YEDITEPE-Sayisal-Tasarim-Toplulugu/7Yonga/README.md

# 7Yonga Projesi

Başvuru Yaptığı Takım Adı:
Yeditepe Üniversitesi Sayısal Tasarım Topluluğu 

Takım ID:
#582202 

Başvuru ID:
#3062081 

Takımımız, Yeditepe Üniversitesi Elektrik-Elektronik ve Bilgisayar Mühendisliği lisans
öğrencilerinden oluşmaktadır. 7Yonga projesi kapsamında, açık kaynaklı bir RISC-V çekirdeği, çevre
birimleri ve veri yolları ile özgün bir mikrodenetleyici tasarlamayı hedeflemekteyiz. Bu
mikrodenetleyici, yüksek doğruluk ve düşük güç tüketimi öncelikleri doğrultusunda geliştirilecektir.

## Üyeler
* Muhammet Furkan UZUN (İletişim Sorumlusu) (@mhfuzun)
  - Öğrenim: Yeditepe Üniversitesi, Elektrik-Elektronik Mühendisliği 2. Sınıf öğrencisi.
  - İş yükü: Çekirdeğin, belleklerin, veri yollarının implementasyonu,
donanım hızlandırıcı
* Hasan GÜZELŞEMME (@princeofyozgat)
  - Öğrenim: Yeditepe Üniversitesi, Bilgisayar Mühendisliği 3. Sınıf öğrencisi.
  - İş yükü: Çekirdek implementasyonu, çevre birimleri tasarımı, devre
serimi
* Erhan ÖNALDI (@ErhanOnaldi)
  - Öğrenim: Yeditepe Üniversitesi, Bilgisayar Mühendisliği 4. Sınıf öğrencisi.
  - İş yükü: Çevre Birimleri tasarımı, testler, donanım hızlandırıcı

## Tasarım
<div style="background-color: white; display: inline-block; padding: 0px; border-radius: 8px; box-shadow: 0 0 0px rgba(0,0,0,0.1);">
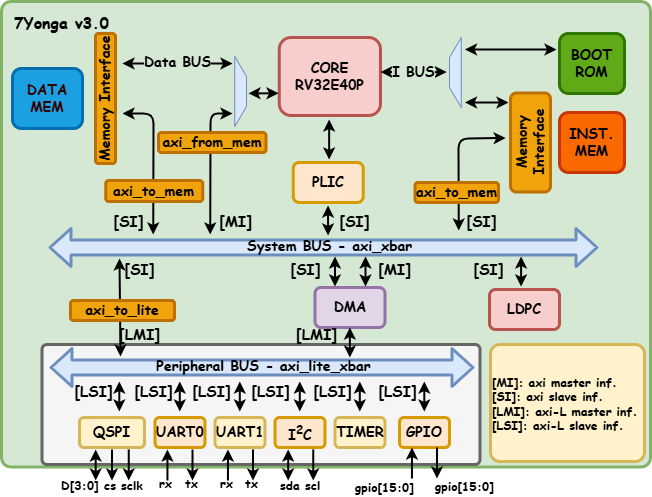
[picture p1: tasarımlar/görseller/YONGA-TASARIM-TOP_v3.0.drawio.png]
  
</div>

## Memory Map
<div style="background-color: white; display: inline-block; padding: 0px; border-radius: 8px; box-shadow: 0 0 0px rgba(0,0,0,0.1);">
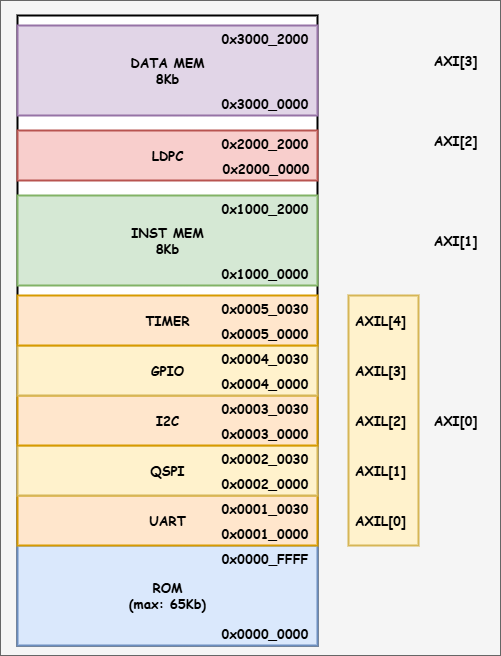
[picture p2: tasarımlar/görseller/YONGA-TASARIM-ADDR_MEMORY_MAP.drawio.png]
  
</div>

## İş Planı
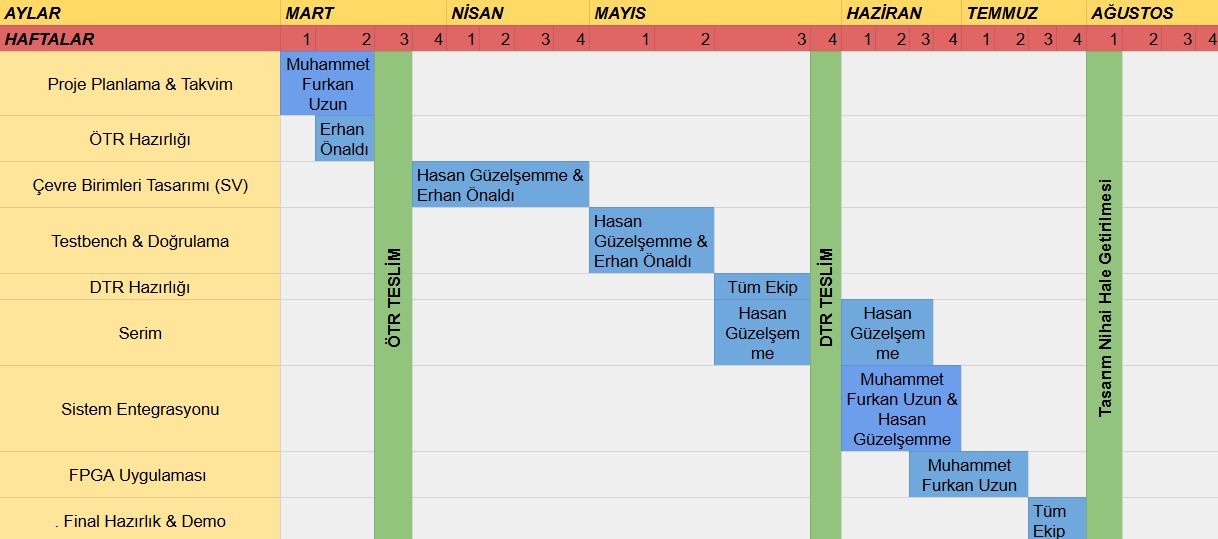
[picture p3: tasarımlar/görseller/isPlani.jpg]
İş Planı


## Dizin Yapısı:
```bash
7Yonga/
│
├── README.md               # Projenin tanıtım dosyası
├── LICENSE                 # Lisans bilgisi
├── .gitignore              # Git tarafından yok sayılacak dosyalar
├── requirements.txt        # Gerekli Python paketleri (Python için)
├── dependences.md          # Bağımlı olunan harici repolar (Makefile dependences ile toplu olarak "clone"'lanabilir)
│
├── docs/                   # Belgeler
│   └── kaynaklar/          # Referans Dokümanlar
|
├── tasarımlar/             # Proje tasarım klasörü, drawio tasarımlarını içerir
│   └── görseller/          # drawio tasarımlarının .jpg/.png çıktılarını içerir
│
├── teknofest/              # Teknofest 2025 Klasörü, Yarışma aşamlarını ve repor (şablonlarını) içerir.
│   └── önbaşvuru/          # Teknofest 2025 ~ Ön Başvuru Aşaması
│   └── dtr/                # Teknofest 2025 ~ DTR Aşaması
│   └── ötr/                # Teknofest 2025 ~ OTR Aşaması
|
│
├── firmware/               # Mikrodenetleyici yazılımlarını içerir
│   └── examples/           # Örnek kaynak kodlar
│   └── step0/              # Verification için kullanılan en basit test template'i
|
├── tasks/                  # Teknofest 2025 gerçekleştirilmesi gereken görevleri içerir
│   └── boot_steps/         # Boot süreci için gerekli donanım blokları ve betikleri bulunur.
│   └── core_verification/  # Çekirdek Doğrulaması Test Ortamı
│     └── testprogram/      # Test için kullanılan programları içerir
│     └── testsuit/         # Top modülü, Çekirdek için sarıcı modülü ve log üretici modülü içerir
│   └── LDPC/               # LDPC çalışma klasörü
│     └── articles/         # LDPC ile ilgli referans kaynaklar
│     └── pdfs/             # LPDC çalışma çıktıları
│   └── Verif/              # Verification ilgili dosyaları
|
├── gateware/               # HDL kodları
│   └── axi4/               # AXI4 Klasörü
│     └── axi/              # Harici AXI4 reposu
│     └── Makefile          # AXI4 reposunu klonlamak için betik
│     └── README.md         # AXI4 reposu ile ilgili karşılaşılan hatalar
│   └── core/               # CORE Klasörü (CV32E40P çekirdeğinin clone reposu)
│   └── inc/                # SOC için Systemverilog Header dosyaları
│   └── peripherals/        # Mikrodenetleyici Çevre Birimleri klasörü
│     └── uart/             # UART Çevre Birimi HDL ve test kodları
│     └── README.MD         #
│   └── pulp_common_cell/   # Pulp Common Cell klasörü, harici repo içerir
│     └── Makefile          # Pulp Common Cell reposunu klonlamak için betik
│   └── soc/                # Mikrodenetleyici SOC yapısına ait HDL kodlarını içerir
│     └── adapter/          # SOC içerisinde bulunan arayüzler için arayüz dönüşümlerini sağlar
│     └── core_interfaces/  # Çekirdeğin SOC içerisindeki sarıcı data&instruction arayüzlerini içerir
│   └── test/               # HDL test klasörü
│
```
