YEDITEPE-Sayisal-Tasarim-Toplulugu/7Yonga/tasarımlar/YONGA-TASARIM.drawio.pdf

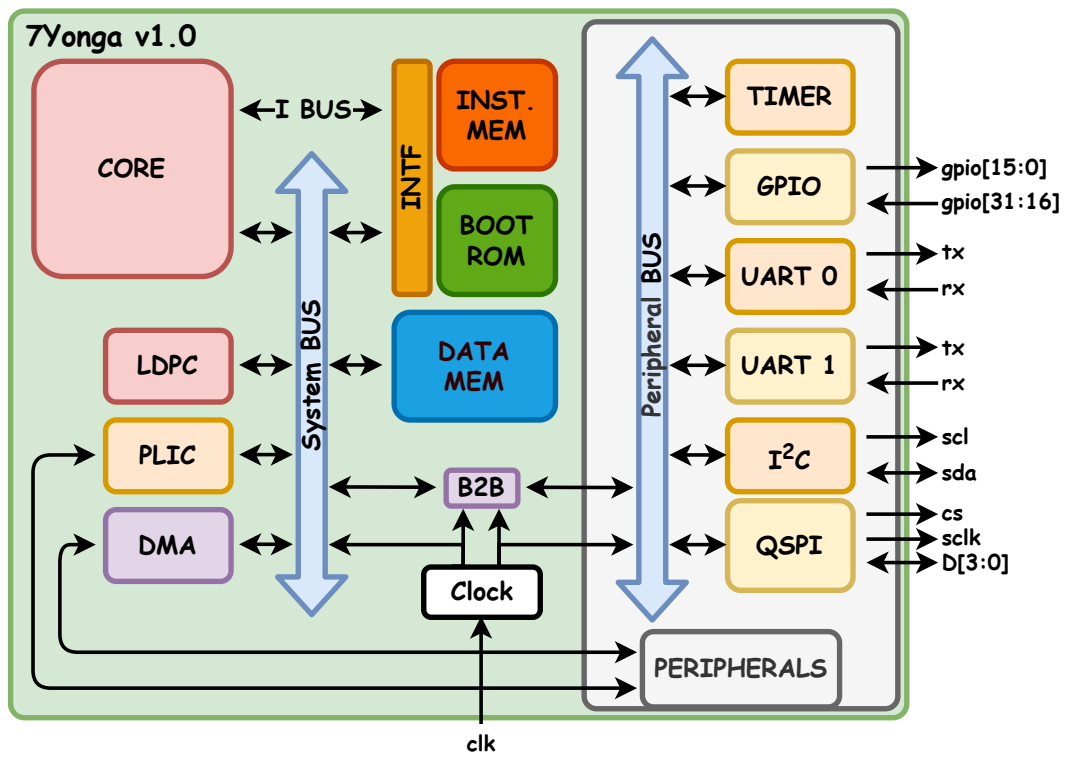
[picture p4: page 1]
CORE; System BUS; DATA MEM; INTF; I BUS; INST.; MEM; BOOT ROM; Peripheral BUS; UART 0; UART 1 I²C; QSPI; GPIO; TIMER; PERIPHERALS; LDPC; PLIC; DMA; Clock; 7Yonga v1.0; gpio[15:0] gpio[31:16]; scl sda cs sclk D[3:0]; clk

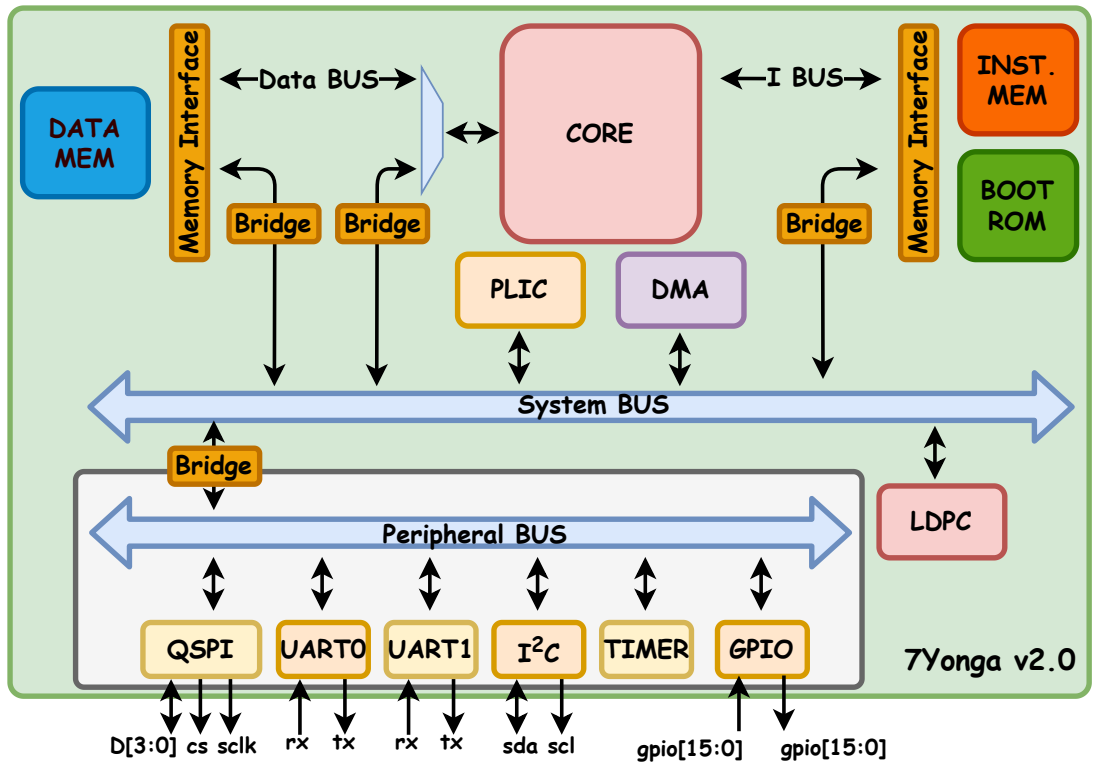
[picture p5: page 2]
CORE; System BUS; DATA MEM; Memory Interface; INST. MEM; BOOT ROM; Peripheral BUS; UART0 UART1; QSPI; TIMER GPIO; LDPC; PLIC; DMA; 7Yonga v2.0; Data BUS; I BUS; Bridge Bridge; Bridge; D[3:0] cs sclk; sda scl; gpio[15:0]

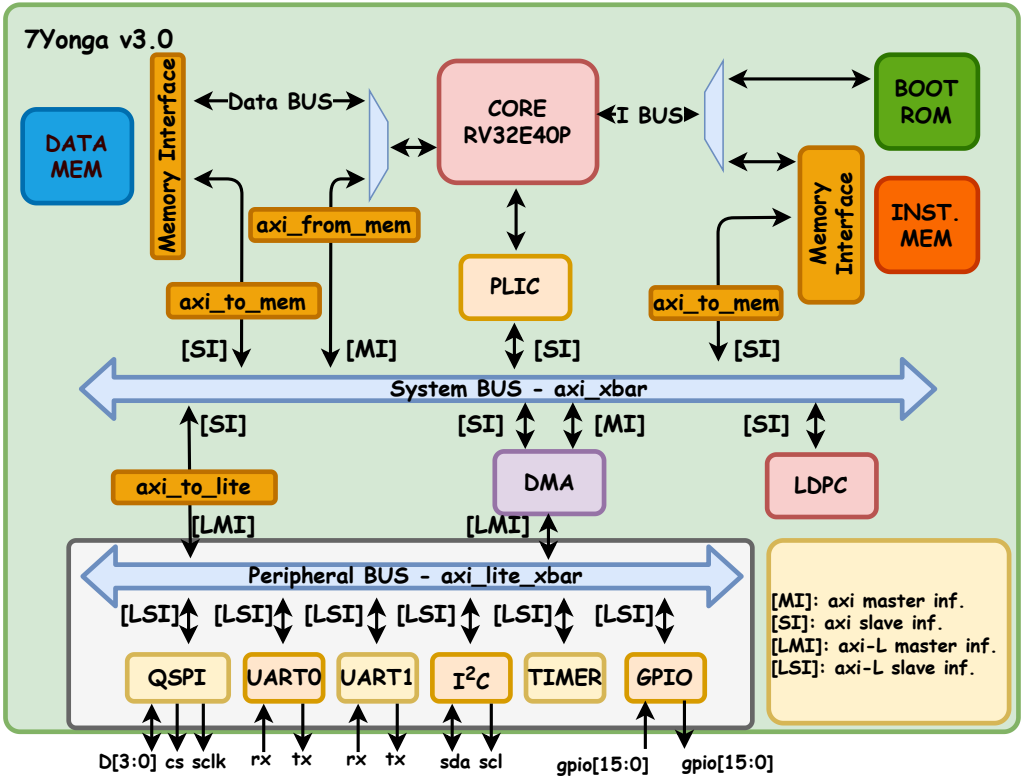
[picture p6: page 3]
CORE RV32E40P; System BUS - axi_xbar; DATA MEM; Memory; Interface; INST. MEM; BOOT ROM; Peripheral BUS - axi_lite_xbar; UART0 UART1; QSPI; TIMER GPIO; LDPC; PLIC; DMA; 7Yonga v3.0; I BUS; Data BUS; Memory Interface; axi_to_mem; axi_from_mem; axi_to_lite; D[3:0] cs sclk; sda scl; gpio[15:0]; [LMI]; [LSI]

[MI]: axi master inf.
[SI]: axi slave inf.
[LMI]: axi-L master inf.
[LSI]: axi-L slave inf.
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
