YEDITEPE-Sayisal-Tasarim-Toplulugu/7Yonga/teknofest/önbaşvuru/_#582202.pdf

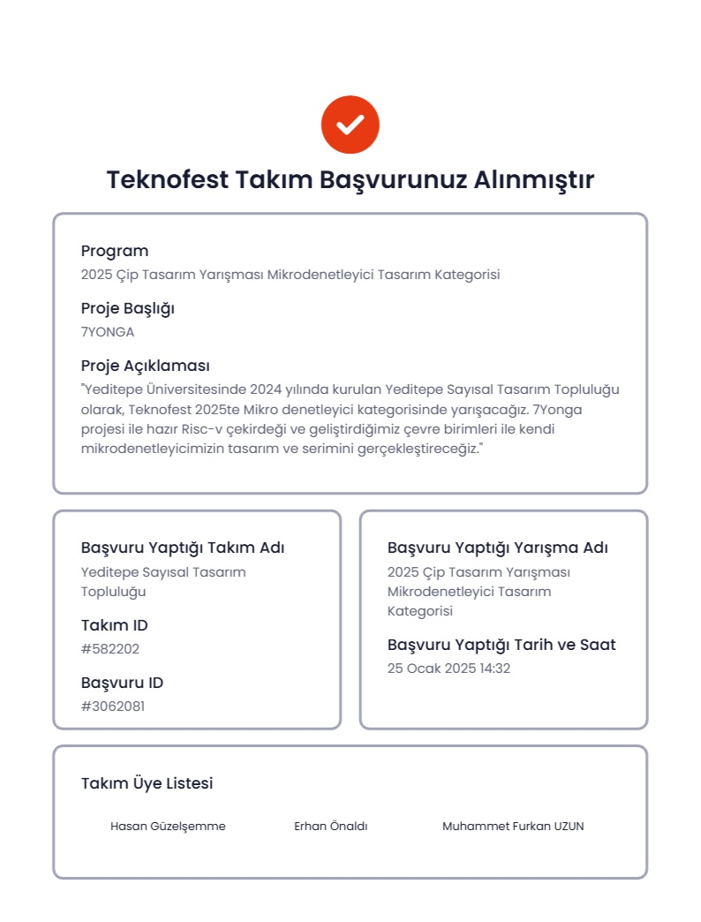
[picture p19: figure]
