YEDITEPE-Sayisal-Tasarim-Toplulugu/7Yonga/docs/kaynaklar/dma-interrupts.png

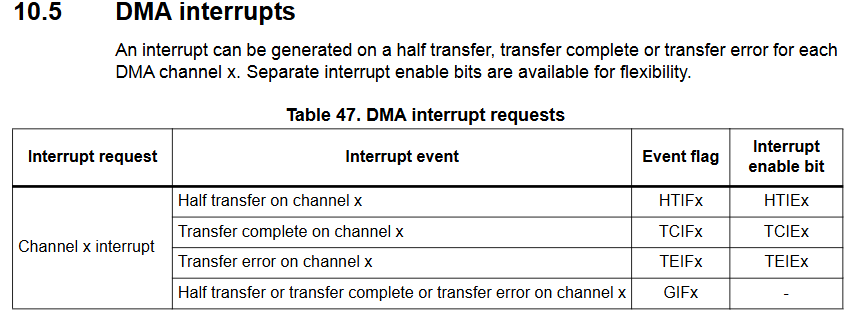
docs/kaynaklar/dma-interrupts.png
