YEDITEPE-Sayisal-Tasarim-Toplulugu/7Yonga/docs/kaynaklar/dma-tasarımı.png

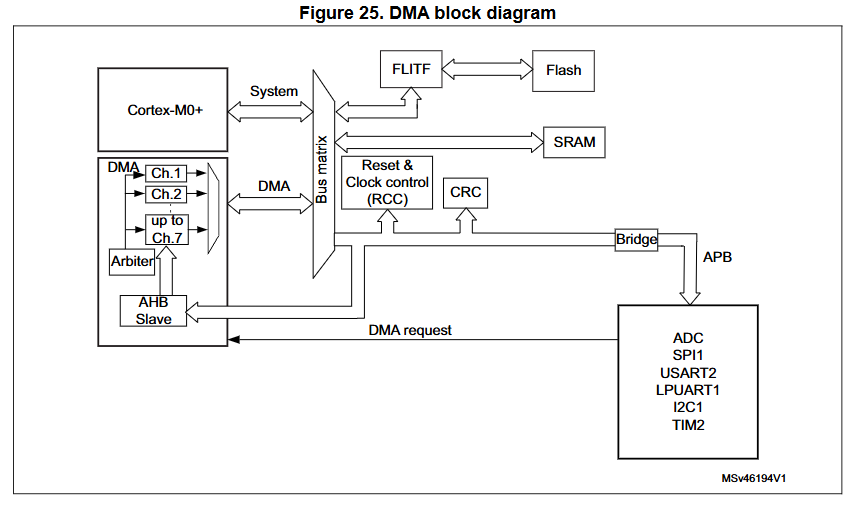
docs/kaynaklar/dma-tasarımı.png
