YEDITEPE-Sayisal-Tasarim-Toplulugu/7Yonga/tasarımlar/görseller/YONGA-TASARIM-BOOT-DEMO.drawio.png

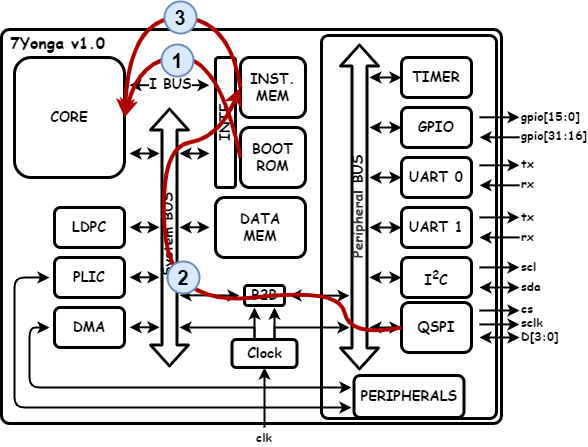
tasarımlar/görseller/YONGA-TASARIM-BOOT-DEMO.drawio.png
