YEDITEPE-Sayisal-Tasarim-Toplulugu/7Yonga/tasarımlar/görseller/YONGA-TASARIM-BOOT-DEMO_v2.0.drawio.png

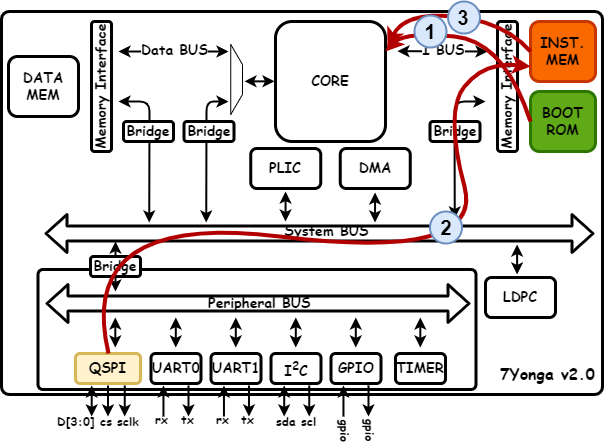
tasarımlar/görseller/YONGA-TASARIM-BOOT-DEMO_v2.0.drawio.png
