YEDITEPE-Sayisal-Tasarim-Toplulugu/7Yonga/tasarımlar/görseller/YONGA-TASARIM-data_interface_rapor.drawio.png

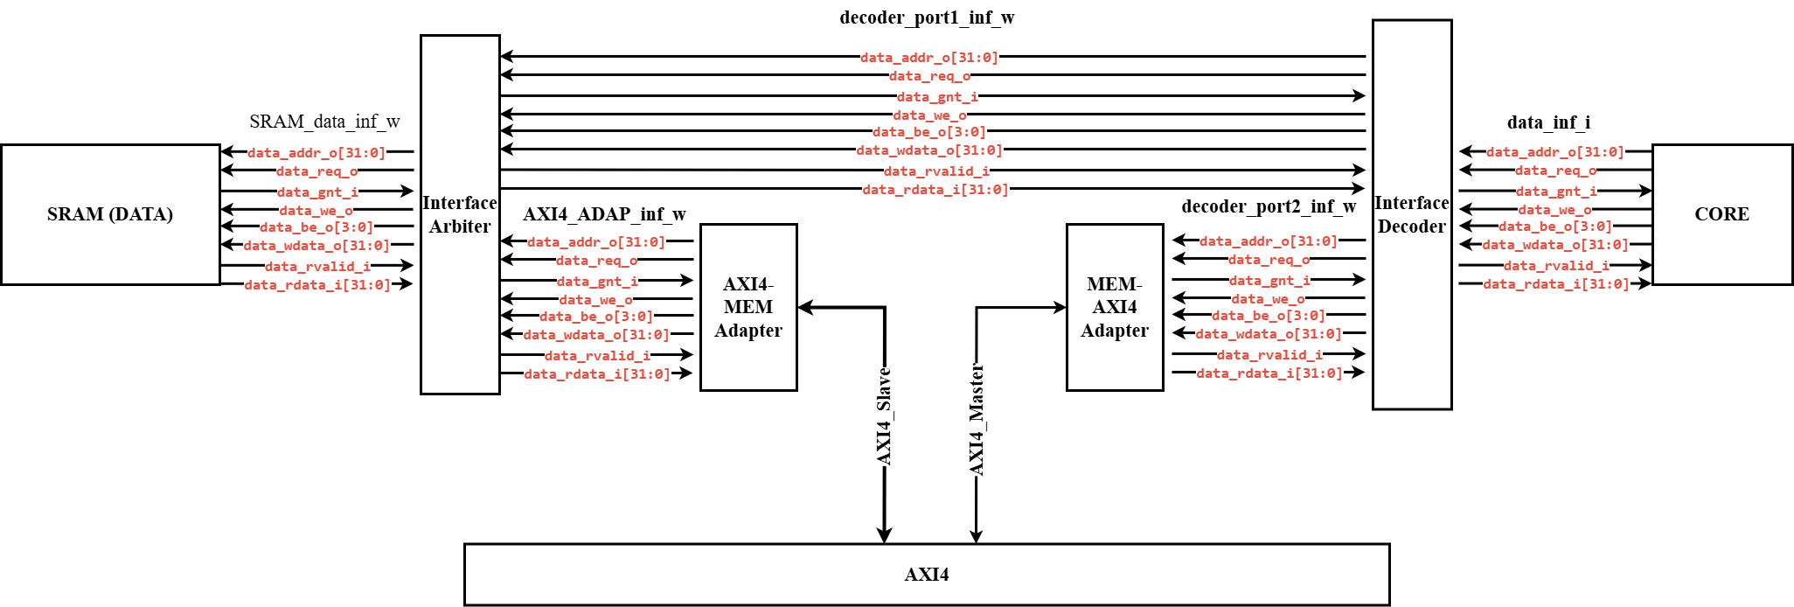
tasarımlar/görseller/YONGA-TASARIM-data_interface_rapor.drawio.png
