YEDITEPE-Sayisal-Tasarim-Toplulugu/7Yonga/tasarımlar/görseller/YONGA-TASARIM-TOP.drawio.png

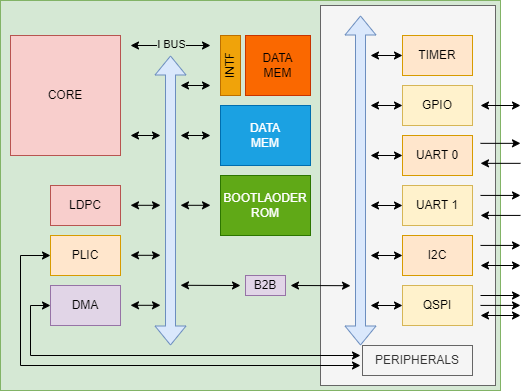
tasarımlar/görseller/YONGA-TASARIM-TOP.drawio.png
