YEDITEPE-Sayisal-Tasarim-Toplulugu/7Yonga/tasarımlar/görseller/YONGA-TASARIM-instruction_interface.drawio.png

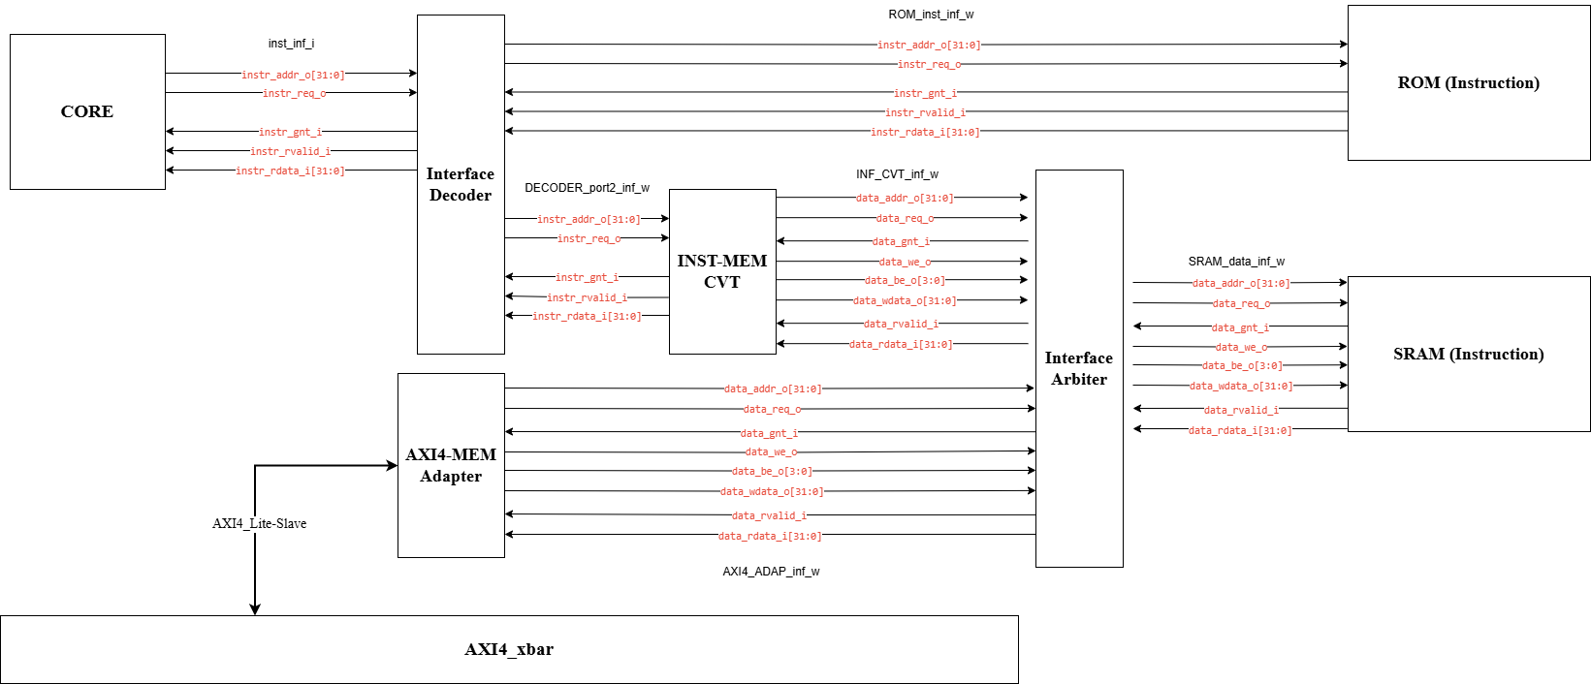
tasarımlar/görseller/YONGA-TASARIM-instruction_interface.drawio.png
