YEDITEPE-Sayisal-Tasarim-Toplulugu/7Yonga/tasarımlar/görseller/YONGA-TASARIM-instruction_interface_rapor.drawio.png

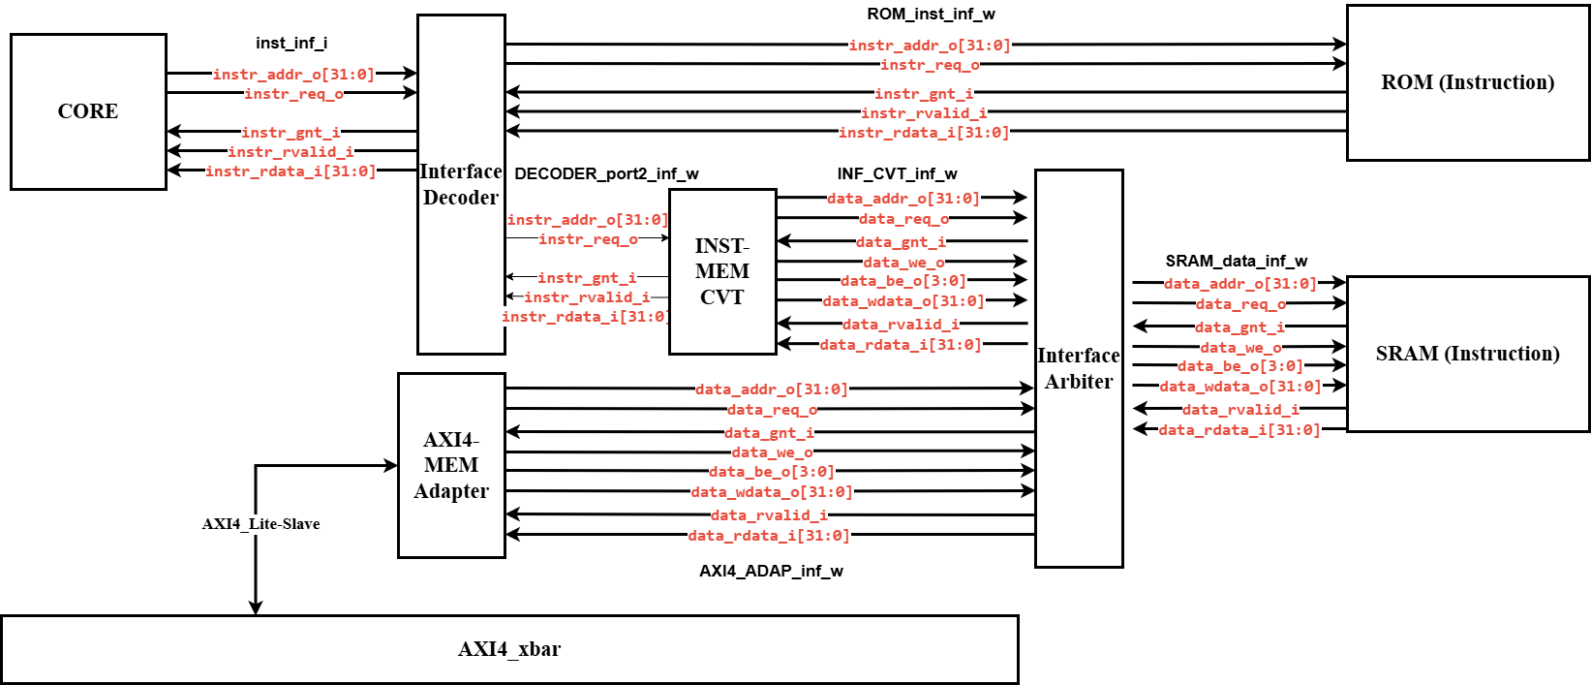
tasarımlar/görseller/YONGA-TASARIM-instruction_interface_rapor.drawio.png
