YEDITEPE-Sayisal-Tasarim-Toplulugu/7Yonga/firmware/loader/SRC/main.c

#include <stdint.h>

// #include "qspi_controller.h"
// #include "flash_controller.h"

// qspi_driver_t qspi_driver;

#define QSPI_BASE_ADDR                              0x10020000
#define SYSTEM_CLOCK                                1000000*50
#define DEFAULT_QSPI_PRESCALER                      31

int main( void ) {
    // QSPI_init(&qspi_driver, QSPI_BASE_ADDR, SYSTEM_CLOCK, DEFAULT_QSPI_PRESCALER);

    return 0;
}
