YEDITEPE-Sayisal-Tasarim-Toplulugu/7Yonga/gateware/soc/adapter/addr_decoder.sv

`timescale 1ns / 1ps
//////////////////////////////////////////////////////////////////////////////////
// Company: 
// Engineer: 
// 
// Create Date: 02.05.2025 10:02:28
// Design Name: 
// Module Name: addr_decoder
// Project Name: 
// Target Devices: 
// Tool Versions: 
// Description: 
// 
// Dependencies: 
// 
// Revision:
// Revision 0.01 - File Created
// Additional Comments:
// 
//////////////////////////////////////////////////////////////////////////////////


module addr_decoder(

    );
endmodule
