YEDITEPE-Sayisal-Tasarim-Toplulugu/7Yonga/(commit log)

2025-04-26 UART module and UART testbench implemented.
2025-04-29 UART modülündeki geçici APB yerine AXI4-Lite arayüzü eklendi
2025-05-16 feat(soc_top): soc_top ile üst sistem eklendi (tamamlanmadı). feat(soc_peripherals_top): peripheral'ler için üst modül oluşturuldu. fix(soc_addr_rules): soc adres kuralları constant olarak düzeltildi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
    [core_data_top.sv, core_instruction_top.sv, cv32e40p_clock_gate.sv, soc_top.sv]
2025-05-17 fix(soc_top): axi xbar addr_map ve conf düzeltildi. feat(soc_peripherals_top): control logic eklendi.
    [soc_top.sv]
2025-05-17 fix(peripheral directory list): çevre birimleri klasör yapısı düzeltildi.
    [tb_uart.sv, uart.sv]
2025-05-17 fix(axi_lite_xbar confg): slave/master port bağlantıları düzeltildi. feat(uart): uart, peripheral top modülüne eklendi.
    [soc_top.sv]
2025-06-08 timer ve gpio eklendi (timer tamamlanacak) ve çevre birimleri dosyası düzenlendi
2025-06-08 timer modülünün geri sayma hatası ve event oluşturma hatası düzeltildi. test bench buna göre güncellendi
2025-06-13 fix, soc files, feat, boot tasks new readme featrures
    [cv32e40p_tb_wrapper.sv, cv32e40p_tracer.sv, cv32e_inst2data_inf_cvt.sv, interface_arbiter.sv, memory_modules.sv, tb_subsystem.sv]
2025-07-28 some errors fix, loop hatası devam ediyor
    [Nexys-A7-100T-Master.xdc, core_data_top.sv, core_instruction_top.sv, interface_arbiter.sv, memory_modules.sv, soc_top.sv, soc_wrapper_vivado.sv]
2025-08-16 qspi driver c kodu
2025-08-17 spi testleri ve düzeltmeleri
2025-08-18 spi fix & driver
    [core_inst_top_v2.sv, main.c, qspi_master.sv, soc_top.sv, soc_wrapper_vivado.sv, tb_programmer_top.sv, tb_soc_wrapper_vivado.sv, uart_engine.sv]
2025-08-25 fix errors & qspi/uart test
    [Nexys-A7-100T-Master.xdc, flash_controller.c, flash_controller.h, main.c, qspi_controller.h, soc_top.sv, soc_wrapper_vivado.sv]
